spincyc/yoke/site/pages/index.md

<span id="connect-endpointskeep-control-at-the-edge" class="legacy-anchor" aria-hidden="true"></span>
<section class="product-hero">
<div class="hero-copy">
<p class="eyebrow">Yoke USB</p>
<h1>Connect USB devices<br>over Ethernet.</h1>
<p class="hero-lead">Plug a USB device into one Yoke box and your computer into another. Connect both boxes to your Ethernet switch. Pair the boxes once; they remember the connection.</p>
<div class="hero-actions"><a class="button" href="usb.md">USB hardware <span aria-hidden="true">→</span></a><a class="text-link" href="how-it-works.md">How it works <span aria-hidden="true">↗</span></a></div>
<p class="hero-note">Prototype: Radxa ZERO 3E. USB 2 first. <a href="docs/project-status.md">Development status</a></p>
</div>
<div class="hero-visual">
<figure id="network-title" class="product-figure"><picture><source media="(max-width: 760px)" srcset="../assets/diagrams/product-scene-mobile.svg">A USB device connects to a Yoke hardware box. Ethernet joins it through a switch to a second Yoke hardware box, which connects by USB to a separate computer.</picture><figcaption id="network-description">Two hardware boxes, with a USB cable at each end.</figcaption></figure>
</div>
</section>

<span id="a-small-command-surface" class="legacy-anchor" aria-hidden="true"></span>
<section class="product-section">
<div class="section-heading"><p class="eyebrow">USB / HDMI / IR</p><h2>Small boxes for the connections you need.</h2><p>USB is the first hardware prototype. HDMI and IR boxes are also part of Yoke. Each box works on its own, with management software as an optional addition.</p></div>
<div class="scenario-grid">
<article class="product-scenario"><span class="feature-number">01 / USB</span><h3>Use a USB device in another room.</h3><p>A box beside the device connects to a second box beside your computer. Both use Ethernet; your computer connects by USB.</p><a href="usb.md">USB hardware <span aria-hidden="true">→</span></a></article>
<article class="product-scenario"><span class="feature-number">02 / HDMI · Planned</span><h3>Connect a video source to a screen.</h3><p>An HDMI box at each end carries the connection over Ethernet. Choose which source feeds each screen.</p><a href="product.md#hdmi">HDMI hardware <span aria-hidden="true">→</span></a></article>
<article class="product-scenario"><span class="feature-number">03 / IR · Planned</span><h3>Control equipment in the cabinet.</h3><p>An Ethernet-connected IR box sends signals to the equipment beside it. A two-jack version is planned for use alongside an existing control system.</p><a href="product.md#ir">IR hardware <span aria-hidden="true">→</span></a></article>
</div>
</section>

<section class="product-section">
<div class="section-heading"><p class="eyebrow">Pairing</p><h2>The boxes remember their pairing.</h2><p>Use a command to pair or unpair boxes. Their saved pairing survives a restart or a lost network connection. If the other box goes offline, the pairing stays saved while it waits.</p></div>
<div class="feature-grid">
<div class="feature"><h3>No running manager required.</h3><p>Close the setup tool after pairing. The boxes keep the connection themselves.</p></div>
<div class="feature"><h3>Use your own tools.</h3><p>Use the command line, Thermite, or another manager. The commands and protocol are documented.</p></div>
<div class="feature"><h3>Check each box.</h3><p>See its saved pairing, connection status, and errors. A separate monitor can listen without changing the pairing.</p></div>
</div>
</section>

<span id="working-software-an-open-hardware-roadmap" class="legacy-anchor" aria-hidden="true"></span>
<span id="follow-the-evidence" class="legacy-anchor" aria-hidden="true"></span>
<section class="product-section status-snapshot">
<div><p class="eyebrow">Development</p><h2>Build the prototype or try the software.</h2><p>The USB design uses two Radxa ZERO 3E boards. Software simulations are available now; the complete USB bridge and hardware tests are still being developed.</p></div>
<div class="hero-actions"><a class="button" href="usb.md">USB prototype <span aria-hidden="true">→</span></a><a id="doc-search" class="text-link" href="docs/index.md#search">Documentation <span aria-hidden="true">↗</span></a></div>
</section>
