spincyc/yoke/hardware/usb-housing/r3/lid-detail.png

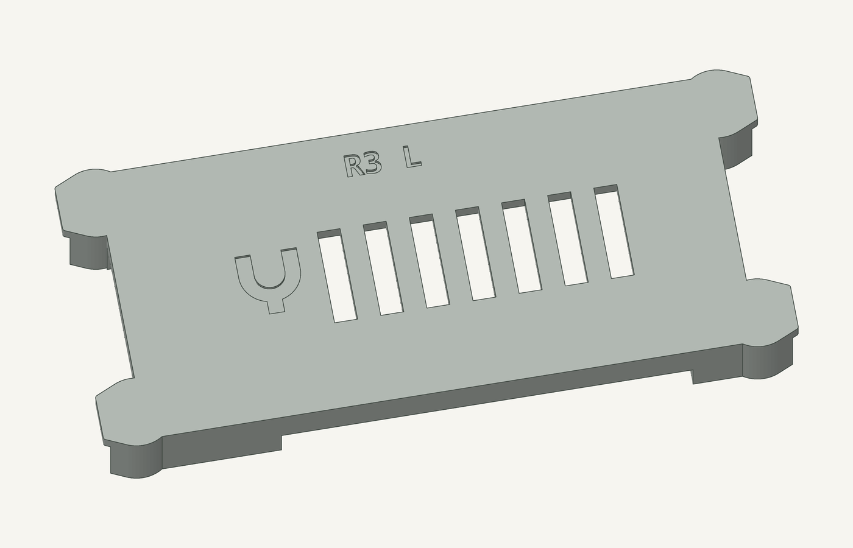
hardware/usb-housing/r3/lid-detail.png
