spincyc/yoke/hardware/usb-housing/r7/exploded.png

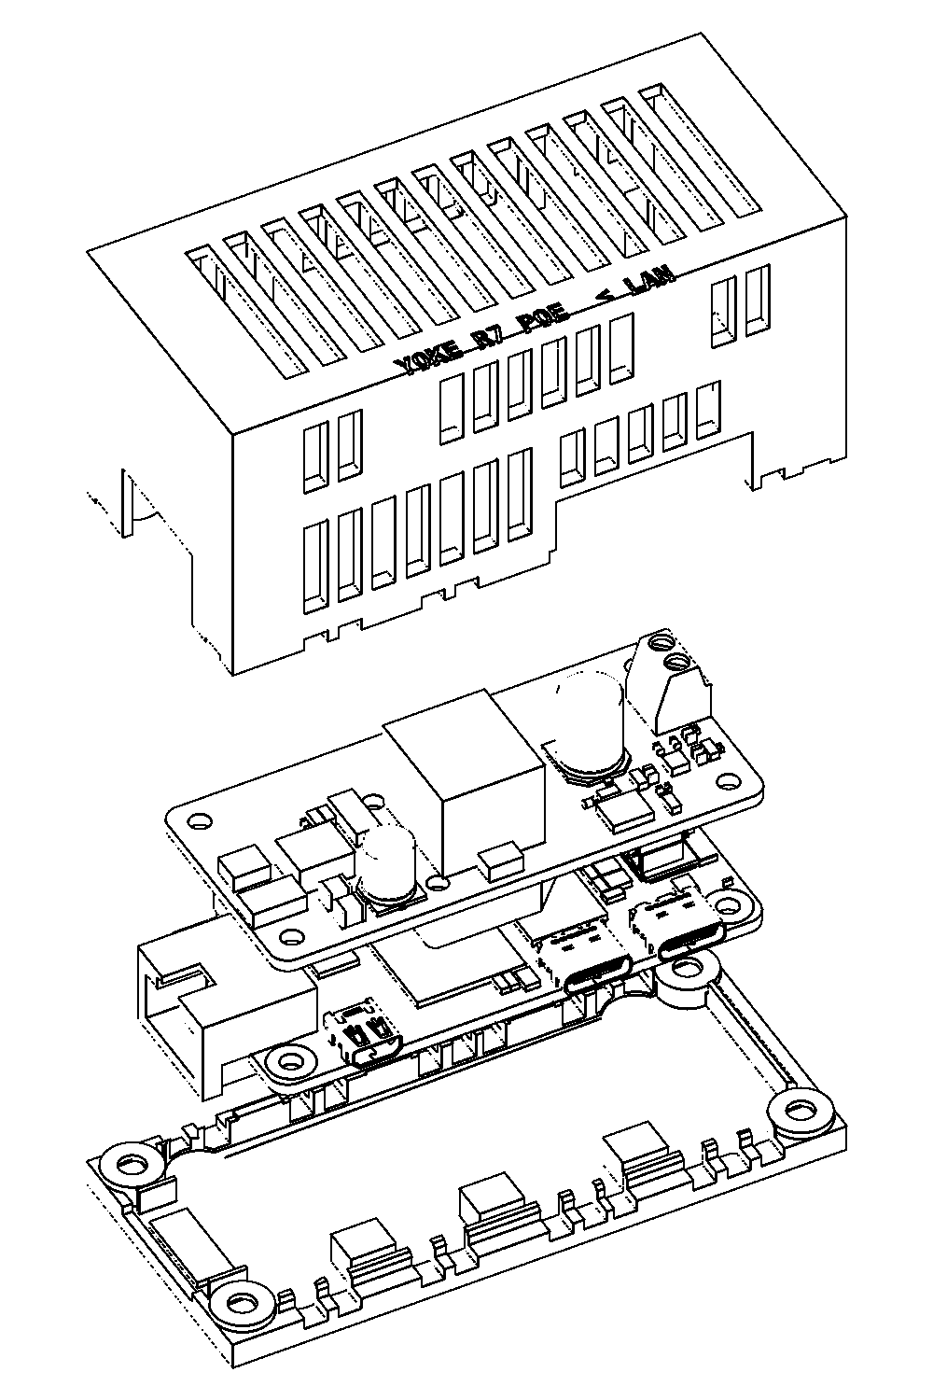
hardware/usb-housing/r7/exploded.png
