spincyc/yoke/hardware/usb-housing/r7/section.png

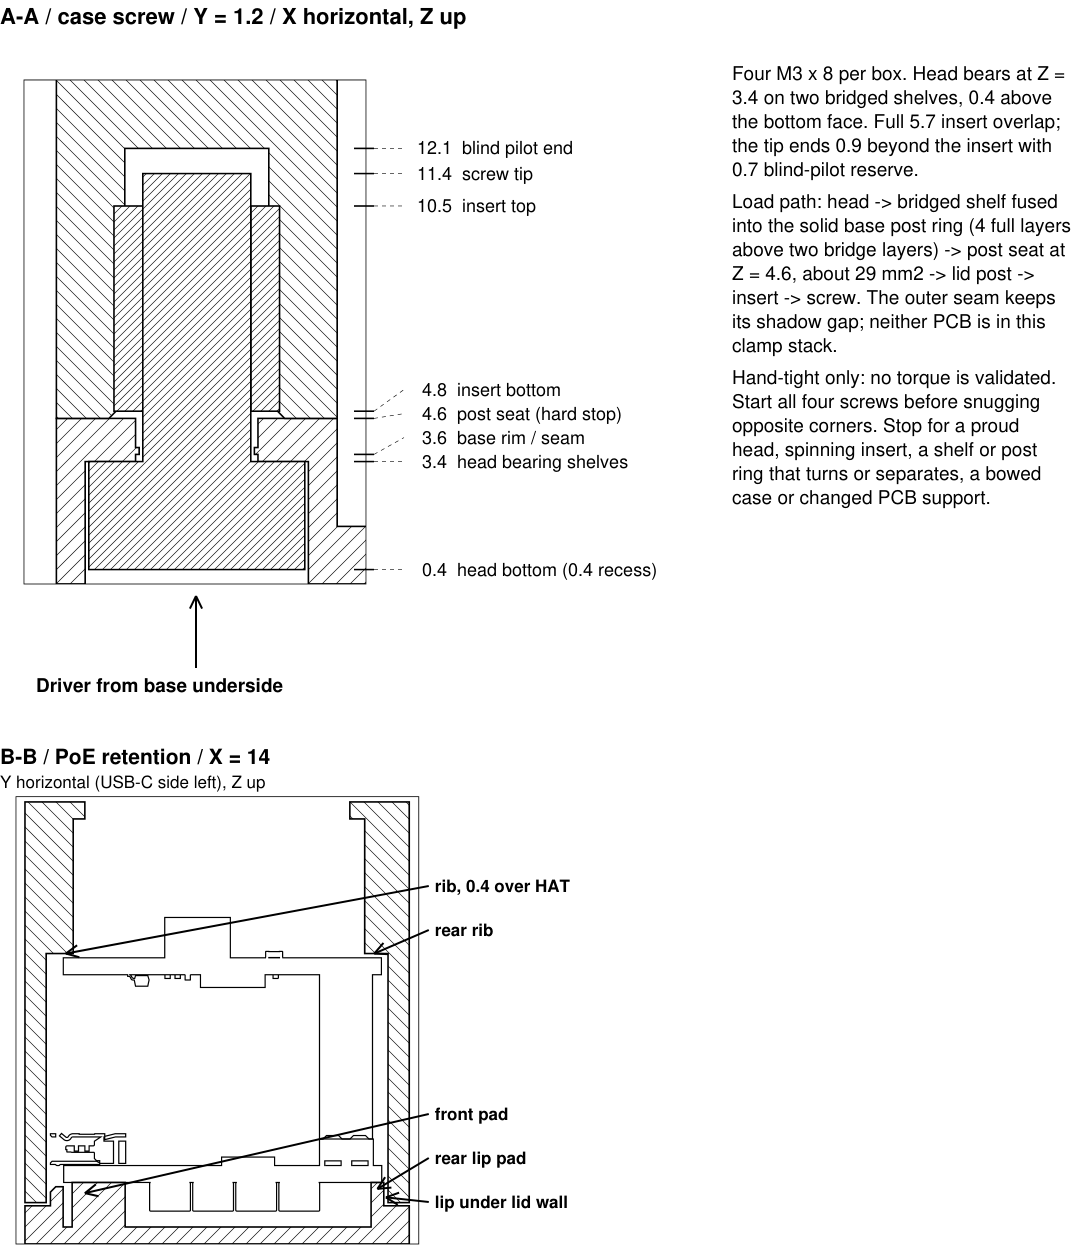
hardware/usb-housing/r7/section.png
