spincyc/yoke/hardware/usb-housing/lid-printed.stl

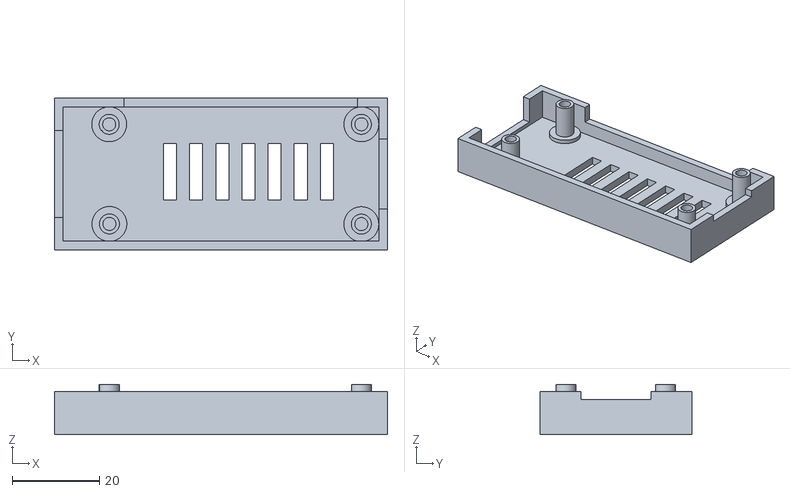
[picture p15: CAD file, 2026-11-02]
hardware/usb-housing/lid-printed.stl
76.4 x 34.8 x 11.5
