spincyc/yoke/hardware/usb-housing/r3/lid-printed.stl

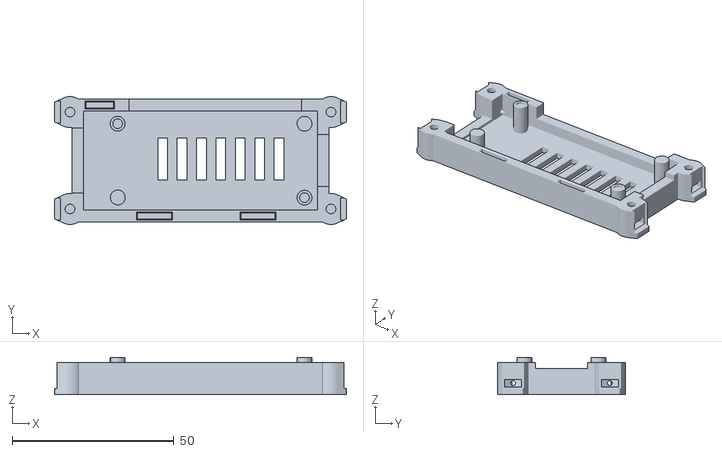
[picture p16: CAD file, 2026-11-03]
hardware/usb-housing/r3/lid-printed.stl
90.4 x 39.6 x 11.5
