spincyc/yoke/hardware/usb-housing/base.stl

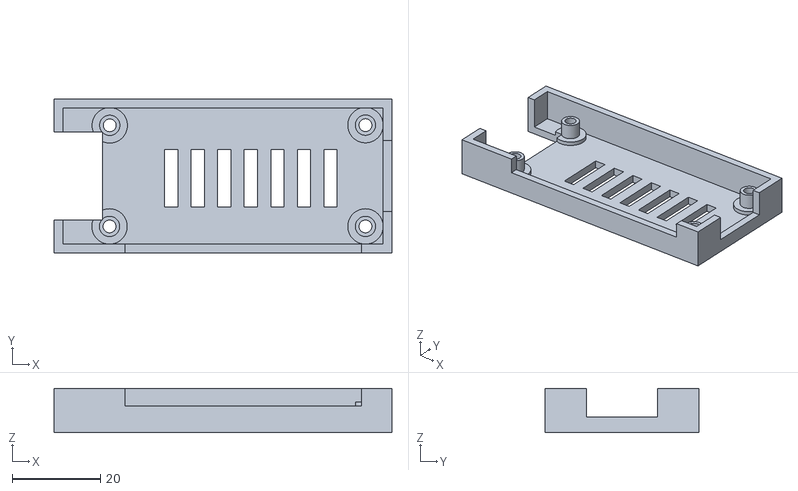
[picture p17: CAD file, 2026-11-02]
hardware/usb-housing/base.stl
76.4 x 34.8 x 10.0
