spincyc/yoke/hardware/usb-housing/r3/coupon-lid-printed.stl

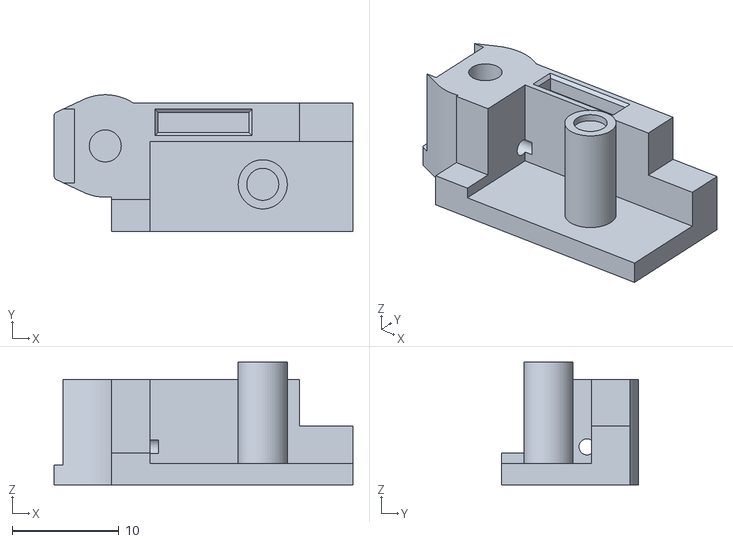
[picture p18: CAD file, 2026-11-03]
hardware/usb-housing/r3/coupon-lid-printed.stl
28.0 x 12.8 x 11.5
