spincyc/yoke/hardware/usb-housing/r2/yoke-usb-housing-r2.stl

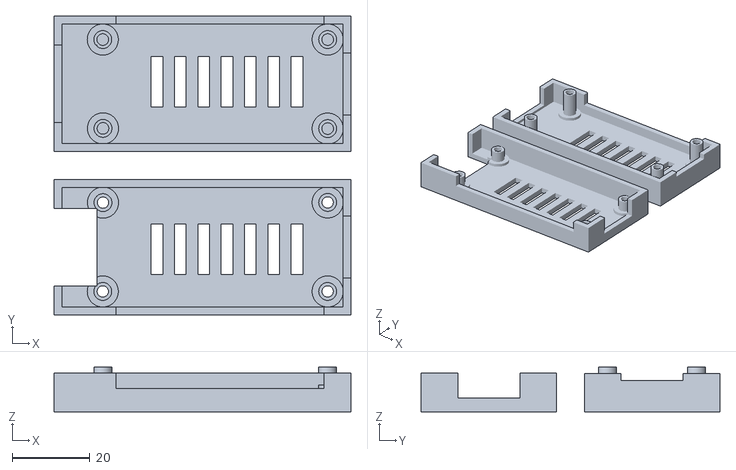
[picture p19: CAD file, 2026-11-02]
hardware/usb-housing/r2/yoke-usb-housing-r2.stl
76.4 x 76.8 x 11.5
