spincyc/yoke/hardware/usb-housing/r3/base-printed.stl

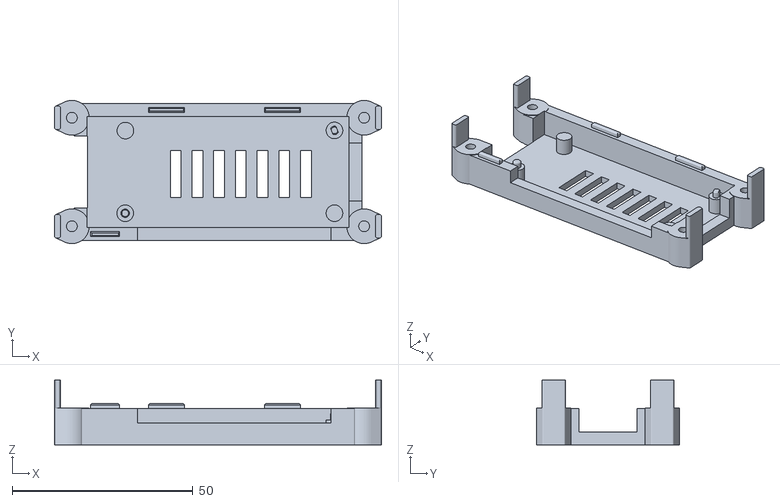
[picture p20: CAD file, 2026-11-03]
hardware/usb-housing/r3/base-printed.stl
90.4 x 39.6 x 17.9
