spincyc/yoke/hardware/usb-housing/r3/yoke-usb-housing-r3-coupon.stl

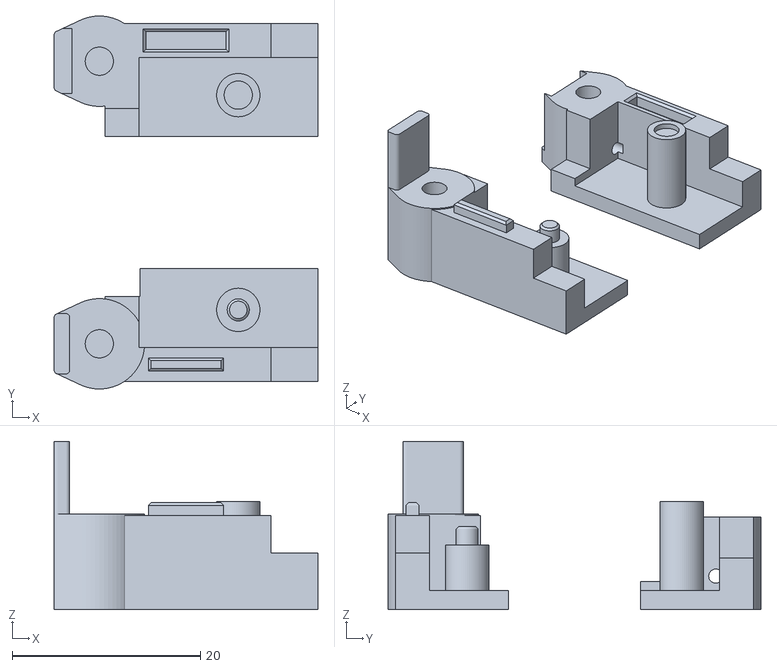
[picture p21: CAD file, 2026-11-03]
hardware/usb-housing/r3/yoke-usb-housing-r3-coupon.stl
28.0 x 39.6 x 17.9
