spincyc/yoke/hardware/usb-housing/r3/coupon-base.stl

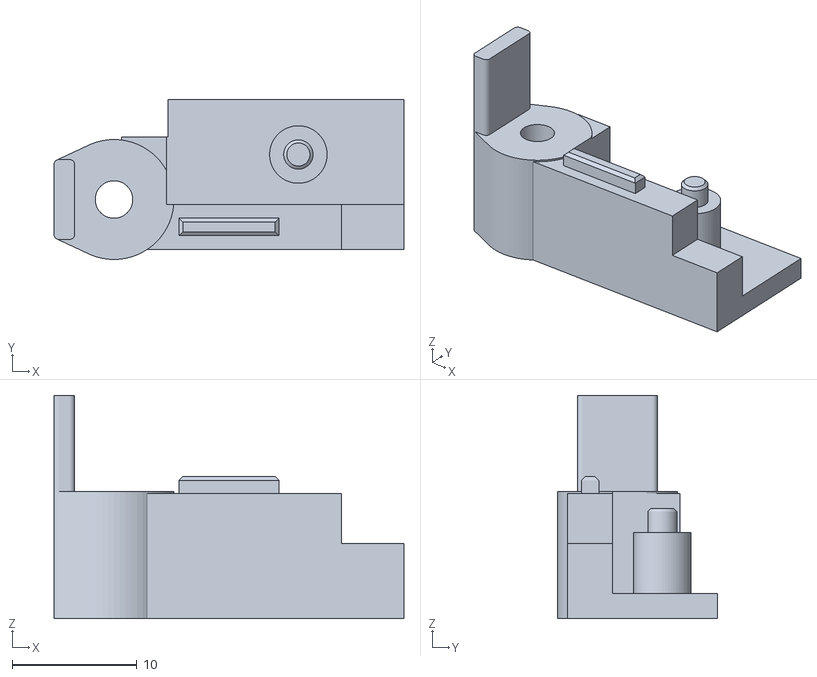
[picture p22: CAD file, 2026-11-03]
hardware/usb-housing/r3/coupon-base.stl
28.0 x 12.8 x 17.9
