spincyc/yoke/hardware/usb-housing/r3/yoke-usb-housing-r3.stl

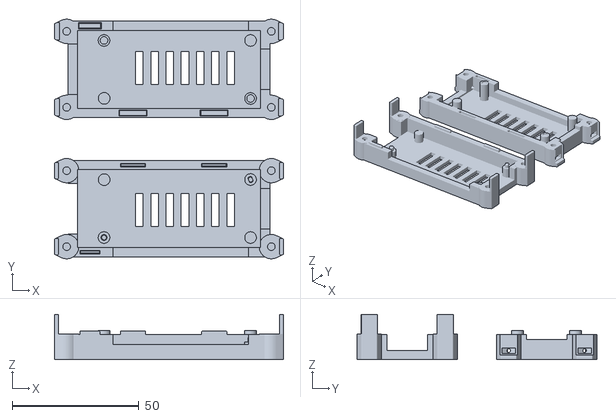
[picture p23: CAD file, 2026-11-03]
hardware/usb-housing/r3/yoke-usb-housing-r3.stl
90.4 x 94.6 x 17.9
