spincyc/yoke/(list of files, cad)

Other CAD files:
hardware/usb-housing/yoke-usb-housing-r1.stl
hardware/usb-housing/lid.stl
hardware/usb-housing/r3/coupon-lid.stl
hardware/usb-housing/r3/lid.stl
hardware/usb-housing/r3/base.stl
hardware/usb-housing/r2/base.stl
hardware/usb-housing/r2/lid-printed.stl
hardware/usb-housing/r2/lid.stl
hardware/usb-housing/r2/housing.scad
hardware/usb-housing/r5/housing.scad
hardware/usb-housing/r6/housing.scad
