spincyc/yoke/site/pages/guides/index.md

# Guides

For the hardware, start with the [USB boxes and wiring](../usb.md).
For software development without boards, [run the tests](../start.md).

## Connect and operate

| Task | Guide |
|---|---|
| USB hardware and firmware work | [Selected design](../../../doc/design/USB-ENDPOINT.md) |
| Change a pairing | [Pair configured endpoints](pairing.md) |
| Inspect devices or add a manager | [Monitor and integrate](monitoring.md) |
| Test a software adapter | [Backend reference](../reference/backends.md) |
| Provision identities, keys, and services | [Deployment](../../../doc/design/DEPLOYMENT.md) |
| Exercise sender, receiver, and observer | [Media testing](../../../doc/design/MEDIA-TESTING.md) |

## Maintain an endpoint

| Task | Guide |
|---|---|
| Update software running inside a box | [Linux updates](../../../doc/design/UPDATES.md) |
| Provision or update the ESP32 reference firmware | [ESP32 updater](../../../doc/design/ESP32-UPDATES.md) |
| Check the case redesign | [Housing status](../../../doc/design/USB-HOUSING.md) |

Update and enclosure guides document development references; see
[project status](../docs/project-status.md) before planning a hardware
deployment. Engineering validation belongs in the
[verification guide](../verification.md).
