spincyc/yoke/firmware/esp32/verify.py

#!/usr/bin/env python3
"""Explicit software-only firmware verification; installs build tools in .scratch.

Requires git, bash, cmake, ninja, cc, OpenSSL, and Python 3.12+. Default mode
downloads pinned developer dependencies. --offline reuses installed tools and
performs no installation. Neither mode contacts or flashes a device.
"""

import argparse
import hashlib
import json
import os
import shutil
import subprocess
import sys
import tomllib
import xml.etree.ElementTree as ET
from pathlib import Path

ROOT = Path(__file__).resolve().parents[2]
SCRATCH = ROOT / ".scratch/esp32-ota"
IDF = SCRATCH / "esp-idf"
IDF_TAG = "v5.5.6"
IDF_COMMIT = "880a203ae603d08a94d06aa01e0d6761958e5e9e"
MINIMUM_TESTS = 132
# ESP32-S3 internal SRAM instruction bus; flash-mapped code is 0x42xxxxxx.
IRAM = range(0x40370000, 0x403E0000)
ISR_SYMBOLS = ("ir_tx_fill", "ir_tx_extend", "__wrap_esp_panic_handler")


def run(command: list[str], env: dict[str, str], *, capture: bool = False) -> str:
    result = subprocess.run(
        command, cwd=ROOT, env=env, check=True, text=True, capture_output=capture
    )
    return result.stdout if capture else ""


def environment(jobs: int) -> dict[str, str]:
    env = dict(os.environ)
    for key in ("PYTHONHOME", "VIRTUAL_ENV", "IDF_PYTHON_ENV_PATH", "PYTEST_ADDOPTS"):
        env.pop(key, None)
    # export.sh must detect the same Python that prepared the SDK environment.
    env["PATH"] = os.pathsep.join(
        [str(Path(sys.executable).parent), str(Path.home() / ".local/bin"), env["PATH"]]
    )
    values = {
        "IDF_PATH": IDF,
        "IDF_TOOLS_PATH": SCRATCH / "tools",
        "TMPDIR": SCRATCH / "tmp",
        "XDG_CACHE_HOME": SCRATCH / "cache",
        "PIP_CACHE_DIR": SCRATCH / "cache/pip",
        "PYTHONPYCACHEPREFIX": SCRATCH / "cache/pycache",
        "CCACHE_DIR": SCRATCH / "cache/ccache",
    }
    for key, value in values.items():
        env[key] = str(value)
        value.mkdir(parents=True, exist_ok=True)
    env["IDF_PY_BUILD_JOBS"] = str(jobs)
    env["PIP_DISABLE_PIP_VERSION_CHECK"] = "1"
    return env


def check_sdk(env: dict[str, str]) -> None:
    actual = run(["git", "-C", str(IDF), "rev-parse", "HEAD"], env, capture=True)
    if actual.strip() != IDF_COMMIT:
        raise RuntimeError(f"SDK must be {IDF_TAG} commit {IDF_COMMIT}")
    changes = run(
        ["git", "-C", str(IDF), "status", "--porcelain", "--untracked-files=no"],
        env,
        capture=True,
    )
    if changes.strip():
        raise RuntimeError("SDK or its submodules have tracked modifications")
    modules = run(
        ["git", "-C", str(IDF), "submodule", "status", "--recursive"], env, capture=True
    )
    if not modules or any(line[:1] != " " for line in modules.splitlines()):
        raise RuntimeError("SDK submodules must match the pinned superproject")
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
