spincyc/yoke/(commit log)

2026-08-08 Design and seam: architecture, YWP/1 protocol, ADRs, core types, wire format
    Yoke pairs HDMI/USB producers to consumers over switched Ethernet with no
    central controller: consumer-owned pairing state, totally ordered multicast
    intents, anti-entropy re-send, HMAC-PSK auth, passive snooper. Media plane
    delegated to endpoint hardware (ADR 0002/0004); sans-I/O core for offline
    testability (ADR 0006).
2026-08-08 Hardware research: JAP primary, IPMX premium, usbip/Icron for USB
    Nine-lane web research synthesized: bit-transparent HDMI over 1GbE is
    impossible (endpoint silicon compresses; HDCP stays in licensed hardware,
    confirming ADR 0004); Just Add Power's per-device API + IGMP decoder-side
    switching is exactly yoke's controllerless model; IPMX/NMOS IS-05 is the
    standards-based upgrade path; USB 3.x over switched Ethernet does not
    exist anywhere. UniFi network prerequisites and bench-verification queue
    recorded.
2026-08-08 JAP decoder driver, agent config, atomic state persistence
    The Just Add Power driver encodes the researched control model (per-device
    channel command; bench-unverified assumptions isolated and executable in
    scripted-transcript tests). TOML config with fail-fast validation; state
    saved via write-fsync-rename so persist-before-ack survives crashes.
    [jap.py]
2026-08-08 Media-plane drivers: shellcmd seam, sim, usbip, igmp reference
    All offline-tested (57 tests): scripted FakeRunner transcripts encode the
    exact usbip output formats coded against; IGMP driver joins membership
    only and never reads payload; SimDriver is scriptable for every failure
    mode the simulation needs.
    [igmp.py, shellcmd.py, sim.py, usbip.py]
2026-08-08 Frames hardening from review; deployment guide and examples
    The 101-test frames suite exposed three gaps, now fixed with regressions:
    v accepted true/1.0 via Python equality, encode allowed bool seq, and the
    integers-only rule was unenforced (now: encoders reject floats outside
    ts, decoders stay tolerant — PROTOCOL.md updated to say exactly that).
2026-08-08 Multicast socket helper with loopback smoke test; contributor guidance
2026-08-08 Sans-I/O node state machine with full offline test suite
    Consumer intent pipeline (persist-before-ack, idempotent re-ack, version
    supersession, rejections), driver-status transitions with capped backoff,
    peer tracking with loss/return semantics, anti-entropy intent cache with
    verbatim re-send and suppression, replay defense, rate-limited rx-drop
    telemetry, deterministic seeded jitter. Spec resolutions recorded in the
    module docstring.
2026-08-08 Asyncio agent runner; integration fixes from lane review
    Runner executes node effects in order with driver I/O isolated on a
    locked thread, survives persist failures and encode bugs, and sends bye
    on cancellation. Integration gaps closed: Node.node_id is public, and
    usbip producers now bind at start / unbind at stop with failures
    surfacing as driver-error events (regression-tested).
2026-08-08 ADR 0009: re-issued anti-entropy; rejected intents evicted mesh-wide
    The simulation suite exposed a livelock: verbatim intent re-sends were
    stale-dropped once the author's seq advanced via traffic to any other
    consumer, so an offline consumer could never converge and bystanders
    re-offered forever. Anti-entropy now re-issues the cached intent body
    under the relayer's own origin/seq (authorship preserved in the body
    version); nodes observe rejection acks and evict/pin the exact rejected
    version so doomed intents stop circulating. Convergence property tests
    unpinned (shared origins + invalid intents, seeds 0-99 clean); livelock
    and rejection-eviction regressions added at both node and mesh leve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
2026-08-08 Adversarial review fixes: DoS hardening, deferred-kind, seq unit, docs
    22 confirmed findings from a multi-agent review, addressed:
    Critical: a non-ASCII sig crashed hmac.compare_digest (TypeError) before
    verification, so one crafted datagram killed every agent and the snooper
    in open OR keyed mode. sig now must be 64-hex-or-empty before compare
    (ADR 0010).
    Major: deferred kind-mismatch no longer attaches wrong-kind media (and
    role-flips detach + go pending); a spoofed far-future seq can no longer
    permanently mute an origin (seq unified on Unix nanoseconds via exact
    integer math, bounded 1h ahead — ADR 0007/0010); per-origin maps are
    pruned and FIFO-capped against id-cycling exhaustion; r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
2026-08-08 Field-scenario coverage: shared producer, re-pair, producer reboot, forged frame
    Five simnet scenarios for realistic field conditions: two HDMI consumers
    sharing one producer (independent pairings, both active), re-patching a
    consumer between producers, producer reboot mid-stream with recovery, a
    forged wrong-PSK frame ignored, and unpair-then-repair. Two behavioral
    properties documented inline: re-pair relies on driver-level group switch
    (no explicit detach), and unpair surfaces as pairing-applied(null) rather
    than media-down.
2026-08-09 Prototype-to-product hardware research and phased build plan
    Nine-lane research synthesized into a buildable plan. Core findings:
    uncompressed video over IP (RFC4175/ST2110) is bit-transparent, zero-
    license, and fits 1080p60 on 10G / 4K60 on 25G — the user's fabric makes
    'interpret and reproduce transparently' literally uncompressed pixels
    over Ethernet. VC-2/Dirac is the royalty-free compressor for the one cell
    that doesn't fit. Latency: SBC ~35-55ms, FPGA line-based ~5-16ms. Biggest
    shortcut: Sunshine + moonlight-embedded -platform rk is a finished
    network->real-HDMI consumer on RK3588. HDCP is the hard fork for protected
    content (Apple TV/Sony): licensed repeater required (no per-unit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
2026-08-09 Compression sweet-spot analysis: the latency cliff and the visually-lossless band
    Quantifies the sliding-compression trade-space: latency vs ratio is flat
    (sub-ms) through the line-based regime (~1:1-6:1) then cliffs to 16-80ms
    at frame-based coding. Sweet spot = line-based, visually-lossless, ~2.5-
    4:1, sub-1ms, turning 4K60's ~10Gbps into ~2.5-4Gbps. The saved headroom
    funds ST2022-7/FEC, so a little compression is the reliability play that
    makes transparent survive a shared switched fabric — plus a closed-loop
    controller that slides within the visually-lossless band under QoS
    pressure. Design center for both the unprotected mesh and the licensed
    product; needs a line-based codec (SVT-JP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
2026-08-09 Media pipeline seams: sans-I/O stage contracts, types, design, hardware pick
    The media plane mirrors the control plane: sans-I/O Stage transforms
    emitting observable StageEvent taps, a Pipeline that threads units with
    fan-out, and a non-interference contract (forward output independent of
    who reads the taps) that makes the stream snoop-verifiable. MediaUnit
    carries a source digest for end-to-end integrity. MEDIA.md is normative;
    HARDWARE-PLATFORM.md gives the staged platform pick (pure software now ->
    x86+E810 for the JPEG-XS sweet spot -> FPGA -> licensed product).
2026-08-09 Media pipeline stages, snooper, metrics, stream driver, network sim
    Six sans-I/O stages (source, codec, ratecontrol, packetize, fec, jitter,
    sink), a passive white-box+black-box media snooper and metrics collector,
    the stream media driver (control-plane -> pipeline-process bridge via an
    injected supervisor seam), and a seeded media network simulator. Each
    stage independently tested; the snooper reconstructs stream health from
    taps or the wire without touching the stream (oracle + non-interference
    tested). All stdlib-only, mypy --strict, offline.
2026-08-09 Media wire codec and pipeline assembly
    wire.py bridges the sans-I/O pipeline to real sockets: a PACKET unit
    becomes [RTP header][yoke trailer][fragment] and back losslessly, keeping
    the leading RTP header standard so the black-box snooper parses it off the
    wire. assembly.py composes the canonical sender/receiver pipelines from
    one MediaConfig so the runner, offline tests, and CLI build identical
    stacks. Validated end-to-end in-process (source->wire->sink, bit-exact).
2026-08-09 Asyncio media runner over real UDP; loopback-validated end to end
    SenderRunner produces frames at cadence and sends wire packets, consuming
    feedback to drive rate control; ReceiverRunner ingests packets, ticks the
    jitter buffer, emits feedback, and feeds a passive snooper. Smoke: 60
    frames over 127.0.0.1, bit-exact, zero loss, feedback flowing.
2026-08-09 Media end-to-end tests (offline sim + real-socket loopback); metrics/wire fixes
    Offline integration over the seeded sim (13 tests): clean, loss with/
    without FEC (XOR recovers 51 vs 40 frames under 7% loss; dup survives a
    full path loss), reorder+jitter resequencing, rate adaptation (2.5->6.0,
    frame_bytes 212->88), corruption caught. Real-socket loopback (9 tests
    over 127.0.0.1): bit-exact delivery, snooper non-interference verified,
    malformed datagrams counted, feedback loop, dup-FEC dedup, multi-fragment
    reassembly, measured loopback latency mean ~8.3ms/max ~16.5ms.
    Fixes from integration: MetricsCollector wire boundary now measures at
    packetize(OUT)/depacketize(IN) — the stages that em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
2026-08-09 yoke media debug CLI, two-host make targets, correct effective-ratio metric
    CLI (19 tests): simulate/probe/trace/snoop/run with --dry-run — all logic
    in pure string-returning helpers, sockets only in main(). 'run --role
    sender|receiver' is the single-command two-host entry; make media-send
    PEER=/media-recv wrap it. Registered yoke-media console script.
    Effective ratio now uses the codec's own applied ratio (raw 1.00:1,
    jpegxs 2.50:1) instead of dividing mismatched modeled/actual byte bases
    that read a nonsense 2923:1. README documents the media plane + tools.
2026-08-09 Fix stream sender socket to bind ephemeral, not the destination port
    The live 'yoke media run --role sender' bound the receiver's port on the
    same host, stealing its inbound datagrams (harmless across two hosts via
    multicast, but broke same-host loopback demonstration). Senders now bind
    an ephemeral local port and send to the destination; multicast senders set
    TTL/LOOP. Validated: two CLI processes over 127.0.0.1 deliver frames
    bit-exact with the snooper reconstructing every stage.
2026-08-09 Deep FPGA cost search: floor is ~$130-195/endpoint (Gowin), not $500
    Two research lanes: the Xilinx/Kintex route really does sit ~$500/endpoint
    (cheapest K7+SFP+ board has no HDMI -> add an FMC HDMI card), but the Gowin
    GW5A route (Sipeed Tang Mega 138K Pro ~$175-195) undercuts it 2.5-4x with
    native DVI-Rx capture + 2x SFP+ 12.5G, carrying uncompressed 1080p60. Both
    agree: HDMI-in is the gatekeeper (kills ECP5/Colorlight), no free FPGA
    compression core exists, Artix/ECP5 can't clock 10G, HDCP is a separate
    wall, two endpoints double the cost. Gowin TMDS-Rx margin + toolchain
    maturity are the risks to pilot. FPGA-COST.md has the head-to-head.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
2026-08-09 Add handoff doc for the next agent
    Captures project state (control plane + software media pipeline, all
    committed, make verify green), the evolved requirements — especially the
    late-stated 4K120 absolute-floor and pin-to-pin (not GStreamer) product
    constraints — and the honest hardware conclusion: 4K120 needs HDMI 2.1 FRL
    ingest + 25G+ GTY FPGA + licensed light compression (the $k/licensed
    tier), while the cheap $130-195 Gowin path only prototypes the 1080p60
    architecture. Records open decisions and the top next task (a focused
    4K120 hardware search, not yet done).
2026-08-09 Establish the 4K120 hardware floor (four-lane deep search)
    Transparent 4K120 over switched IP is bleeding-edge — nothing commercial
    ships it (all AVoIP caps at 4K60/HDMI2.0/10G). The whole problem reduces
    to HDMI 2.1 FRL ingest, which is Lontium-or-Bitec: merchant 4K120 FRL RX
    silicon is essentially Lontium alone (~$15-25/chip). Letting the Lontium
    bridge do FRL+DSC decode avoids the paid AMD HDMI2.1/DSC/HDCP IP for the
    license-free DIY path. Format fork sets the tier: 4:2:2-10 (~20G) fits 25G
    uncompressed license-free (strict superset of cinematic HDR sources), 4:4:4
    (~30G) needs 100G or self-DSC. Floors: cinematic prototype ~$1,650-2,000/
    endpoint license-free (Lontium FRL4 + KU5P FMC +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
2026-08-09 Persist the closet-to-desk KVM build spec for a cold agent
    Captures the first committed concrete build: transparent full-bandwidth
    (4K120) low-latency PC-gaming KVM, A/V closet -> remote monitor+USB.
    Diagnosed why commercial extenders fail (USB wedges = relayed timing w/ no
    supervisor; video flicker/black = EDID/HPD + FRL link-training, not
    bandwidth) and the build principle that fixes both (terminate+regenerate +
    own session state + yoke as supervisor). Build order HDMI-handshake-first
    -> USB -> integrate; parts, milestones, and the two open decisions
    (transport, monitor spec). HANDOFF.md now points to it as the active work.
2026-08-09 Design the edge devices: full HDMI + USB paths over switched UniFi
    Transport decided by the user: the switched UniFi network; point-to-point
    fiber ruled out. New requirement folded in: the USB mesh must carry
    WinWing gear including their USB3 video displays.
    doc/design/EDGE-DEVICES.md is new: full-path designs, buyable BOMs, and
    milestone revisions, synthesized from a nine-lane live-web hardware
    search and hardened by a three-lens adversarial review (all confirmed
    findings folded in — EDID synthesis not passthrough, HPD hysteresis +
    local-training rule, GXC D-PHY 20G gate, DSC-as-EDID-knob, Windows-only
    T1 status, PC-side watchdog, Icron waiver, vhusb mesh seam, FEC probe
    gate, restored l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
2026-09-25 Consolidate research into a current, non-contradictory doc set
    Cold review (2026-09-24) of the earlier conclusion that yoke's goal (a
    decentralized, reconfigurable mesh of HDMI and USB bridges over switched
    IP) is not possible. Rejected: that conclusion conflated "no one sells
    it" with "cannot be built", assumed 25G uncompressed as the only 4K120
    route, and missed GPU-side DSC. On the user's 10GbE baseline, 4K120 fits
    as the GPU's own DSC stream over DisplayPort (~8 Gb/s, sub-ms, gated on
    Lontium NDA silicon); only bit-exact 4K 4:4:4 at >=60 Hz (physics) and
    HDCP in a DIY endpoint (law) are impossible.
    - New doc/research/FEASIBILITY.md: verdict, arithmetic, ranked 4K120
    routes, and a tabl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
    [stream.py]
2026-09-25 HDCP pass-through: correct the feasibility verdict, propose ADR 0011
    The earlier docs held that protected content needs a licensed HDCP
    repeater and that the locality check makes a relay impossible. Both are
    wrong for a LAN: a bridge that forwards ciphertext untouched and tunnels
    the DDC handshake verbatim is invisible to source and sink (how HDMI
    extenders work), and the locality check allows 20 ms round trip on HDMI
    against ~0.3 ms on a switched LAN. The real limit is bandwidth:
    ciphertext cannot be compressed, so 10G carries protected content up to
    ~4K60 4:2:0 or 4K24; 4K60 4:2:2 12-bit needs 25G, 4K120 40G+.
    - FEASIBILITY.md: new HDCP section (rates, raw-capture/timing/handshake
    requi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
2026-11-02 Prepare standalone Yoke endpoints and public documentation
    Make pairing commits durable, bound and serialize backend effects, and
    reconcile USB/IP imports without disturbing unrelated sessions. Add
    software fault campaigns, multicast media observation, bounded transport
    models, and measured performance improvements.
    Provide operator-controlled Linux/ESP32 Ethernet update references,
    reviewed Radxa housing files and shared restrained brand assets. Add an
    accessible local docs site gated by Python and firmware checks.
    Validation: make verify (1,445 tests); ESP32 verifier (39 tests, no skips,
    plus target build); independent control, media, driver, update, and CAD
    reviews. Physical endpoint be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
    [base.stl, housing.scad, lid-printed.stl, lid.stl, partitions.csv, yoke-usb-housing-r1.stl, yoke-usb-housing-r2.stl]
2026-11-02 Add optional telemetry export and endpoint terminal monitor
    Passively observe accepted YWP/1 frames, sample collector-host resources,
    and cache Prometheus and versioned JSON snapshots without affecting agents
    or routing. Add a reusable Python curses monitor with offline demo, remote
    viewing, bounded histories, and explicit source freshness and host scope.
    Document research, cadence, counter semantics, network exposure and measured
    software costs. Keep the runtime standard-library-only and monitoring
    independent of Thermite or any other manager.
    Validation: 1698 tests passed, 10 optional firmware SDK tests skipped locally;
    41-page strict docs build; independent cold reviews and real PTY che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
2026-11-03 Revise USB housing with locating joints and recessed metal fasteners
    The earlier flat seam did not register the halves and its screw heads sat
    outside the base. R3 adds three locating tongues, board locating pegs,
    recessed head wells, and side-loaded metal nuts captured by integral keepers
    when the case is closed. End lugs carry preload independently of the PCB.
    Use M2.5 x 16 mm screws, replacing the earlier 20 mm stack. Document the
    larger 90.4 x 39.6 x 20 mm envelope, controlled bore cleanup, measured stack
    acceptance, nut service sequence, fit coupon and bare-board limits. Include
    native CAD, reproducible meshes/plates, exact sections and assembly PDF.
    Validation: nominal geometry and 3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
    [base-printed.stl, base.stl, coupon-base-printed.stl, coupon-base.stl, coupon-lid-printed.stl, coupon-lid.stl, housing.scad, lid-printed.stl]
2026-11-03 Record R3 housing first-article print dispatch
    Record the exact reviewed and approved R3 main-plate job and its single filename-verified printer start. Link the append-only Lacuna ledger and refresh documentation status; physical fit, capture, cleanup, retention and thermal qualification remain NOT RUN.
2026-11-03 Rebuild Yoke around the product and verify Pages in a pinned browser
    Replace the design-review homepage with a restrained product identity, concrete responsive connection diagrams, a pairing demonstration and curated documentation journeys. Preserve existing URLs and anchors, and improve task-first search.
    Separate backend construction, deterministic media experiments, shared presentation helpers and documentation tooling along their existing boundaries while preserving compatibility aliases and behavior.
    Replace environment-dependent Chromium discovery and Node automation with pinned Python Playwright and mandatory browser gates on Python 3.12 and 3.14 before Pages deployment. Validate th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
    [factory.py]
2026-11-03 Correct USB product docs to the agreed two-box hardware design
    Document two Radxa ZERO 3E hardware boxes with physical USB connections to the peripheral and the separate user computer, with USB 2 first. The Linux USB/IP adapter is an unfinished implementation component, not a substitute product topology. Make that distinction explicit in current design docs and older research.
    Rewrite product copy, wiring diagrams, pairing examples and navigation in plain language. Record the owner-reported housing failure and retire R3 recommendations while the rectangular slotted M3 heat-set case is redesigned.
    Validation: make verify (1736 passed, 10 optional SDK skips), 56-page build, 336 browser cases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
2026-11-03 Redesign USB case with a sliding lid and internal M3 fasteners
    Keep the complete enclosure rectangular and recess both screw heads. Use the Lacuna M3 screw and RX heat-set insert types, with native joint coupons before a full-case trial. Add reproducible board-reference generation, nominal geometry checks, assembly drawings and an independent scoped review. Stock fit and all physical tests remain unverified; no R4 print release is issued. Mark earlier case instructions as historical.
    [housing.scad]
2026-11-03 Print reviewed R4 joint samples before a complete USB case
    Add a bounded coupon-trial export and a separate four-page test guide. Provide actual clamp lands and a stiffer rear fixture with a positive lower-part hold-down. The exact five-piece job passed independent assembly and toolpath review, then started once with the expected filename. Preserve the dispatch receipt; actual fit and full-case qualification remain unverified.
    [housing.scad]
2026-11-03 Record the printer material report for the coupon job
2026-11-03 Replace failed housing joints with a simple ventilated two-part case
    [housing.scad]
2026-11-03 Record PoE enclosure gap and current project handoff
2026-11-03 Record PoE housing reference conflict and retire bare-board guidance
2026-11-03 Identify owner PoE kit and distinguish fanless listing from CAD
2026-11-03 Build and dispatch vented R6 PoE housing first article
    [housing.scad]
2026-11-04 Harden control plane: clock-robust admission, USB/IP admission, logging
    Fix the cold-review findings of 2026-11-04 against YWP/1 and the USB/IP
    driver, each with a deterministic regression or simnet scenario:
    - Re-read wall time per frame and poll (node, runner, snoop, telemetry);
    an agent started before NTP now admits peers once the clock steps.
    - Bound the restart sequence floor to 60 s past the durable bound and add
    `yoke agent --rebase-sequence` instead of hand-editing state.
    - Authenticate transmitted bytes with the top-level sig member excised,
    still accepting the legacy canonical form; publish 27 auth vectors.
    - Stop a vanished owned import beside a pre-existing record-less vhc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
    [factory.py]
2026-11-04 Present remote USB devices through the computer-side gadget port
    The computer-side box previously imported the remote device into its own
    kernel with usbip attach, so the user's computer saw nothing. Add the
    missing data path, verified only in pure-software simulation:
    - yoke.usb: a userspace USB/IP 1.1.1 client that imports directly from
    the device-side stock usbipd (no vhci import, no local driver binding)
    and a Raw Gadget presentation backend driven through fcntl.ioctl,
    isolated behind GadgetBackend with ABI constants tested against the
    uapi header (bench-unverified).
    - Proxy: cached descriptors to meet USB 2.0 9.2.6.4 control deadlines,
    forwarded SET_CONFIGURATION/SET_INTERFAC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
    [build.py, factory.py, gadget.py]
2026-11-04 Install the gadget worker on the computer-side box and index ADRs 0021-0024
    The computer role of packaging/zero3e/install.sh now stages the
    unprivileged yoke-gadget worker unit, the raw_gadget module entry and a
    udev rule that gives only the yoke-gadget account access to
    /dev/raw-gadget; yoked stays unchanged. Add the computer-side
    usb-gadget consumer example, describe the driver in the backends
    reference, and list ADRs 0021-0024 in the decisions index.
2026-11-04 Wait for the retry failure before advancing the fake clock
    test_failed_prevalidation_keeps_old_health_stale_and_retries waited on the
    driver's attempt counter, which the executor thread increments when
    attach() starts. On a loaded machine the test advanced the fake clock
    before the failure reached the core, so the next 2 s backoff was
    scheduled past the final advance and the node never retried. Wait for
    the published driver-error event instead, which is emitted in the same
    core call that schedules the retry.
2026-11-04 Turn the ESP32 updater into an RMT IR endpoint with gated health
    IR moves to a standalone ESP32-S3/W5500 endpoint driven by the RMT
    peripheral (ADR 0025), replacing the Radxa pwm-ir-tx and Arduino Mega
    options. A pure-C yoke_ir core parses an honest Global Cache iTach
    subset on TCP 4998 (getdevices, getversion with Make=Yoke, sendir,
    completeir after physical completion, busyIR, stopir, smooth repeat,
    optional learning). The API is off by default, LAN-scoped and rate-
    and size-bounded; admin and OTA stay on mutual-TLS HTTPS.
    Updater hardening (ADR 0026): confirm a new image only after IP or an
    observed link-down plus listeners and an RMT self-test; retry Ethernet
    and restart with RTC-kept b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
    [partitions.csv]
2026-11-04 Fix gadget binding and cancellation; prove the data path on a real kernel
    An independent review found the simulation encoded two wrong kernel
    assumptions. Fixes, each with a test:
    - Raw Gadget binds with the UDC driver name (dwc3-gadget, dummy_udc)
    separate from the device name (fcc00000.usb); the worker infers it
    from sysfs. Previously RUN would fail with EBUSY on the RK3566.
    - Ioctls go through ctypes (one call, GIL released, no PEP 475 retry),
    so pthread_kill cancellation really unblocks EVENT_FETCH/EP_READ and
    teardown is confirmed; per-thread join deadlines.
    - EPIPE after a host CLEAR_FEATURE(HALT) is a cleared halt, not a fault.
    - USB/IP unlink tombstones tolerate the stock st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
    [gadget.py]
2026-11-04 Describe the gadget data path, IR endpoint and computer-side power
    Update the README, project status, architecture tree and engineering
    index for the computer-side USB bridge, the ESP32 RMT IR endpoint and
    the USB-powered computer-side box, and list ADRs 0025 and 0026.
2026-11-04 Replace R6 with compact R7 PoE and computer-side housings, and print them
    The owner judged the printed R6 PoE housing too large (89 x 45.5 x 46 mm).
    Its closed-end screw bosses and USB-side clip boss added about 13 mm of
    length and 9 mm of width and left the USB-C faces 9.5 mm inside the wall.
    R7 puts both boxes on one plate with one shared base design:
    - PoE device-side box 81.4 x 36.25 x 41.7 mm (34% less volume than R6);
    - bare computer-side box 81.4 x 36.25 x 18.5 mm for the USB-powered
    ZERO 3E without a HAT;
    - USB-C faces 2.15 mm from the wall; four recessed M3x8 screws into
    RX-M3x5.7 lid inserts; edge pads and lid ribs instead of clips; only
    the PoE lid depends on the 18 / 14.5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
    [housing.scad]
2026-11-04 Record the 2026-11-04 state: R7 printed, software verified, bench next
    Rewrite HANDOFF around the current state: computer-side gadget bridge
    verified in simulation and a real-kernel VM loopback, control-plane
    hardening, USB-powered computer-side box, ESP32 RMT IR endpoint and the
    R7 housings printed after a second independent review. Point the USB
    endpoint design, README and project status at R7 and the kernel test.
2026-11-04 Record the chipset research and review dispositions of 2026-11-04
    Add dated research pages so later sessions inherit the evidence rather
    than re-deriving it:
    - CHIPSETS.md: RK3566 DWC3 device controller and Raw Gadget naming,
    ZERO 3E OTG power path from the v1.2 schematic, RA023 PoE HAT limits,
    computer-side bus power budget, alternatives (Pi dwc2, MUSB, RK3568,
    RV1106, ESP32-P4, i.MX RT1170, Icron) and IR silicon (Rockchip
    pwm-ir-tx sleep path, ESP32 RMT, AVR), with the bench tests that decide.
    - REVIEW-2026-11-04.md: every consequential cold-review finding across
    the USB data path, control plane, ESP32 firmware, IR and housing, and
    whether it was fixed, accepted or left open.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
2026-11-04 Expect the IR endpoint design first in IR search results
    The browser check required project status within the top five results
    for "IR". The new IR endpoint design, ADR 0025 and the 2026-11-04
    research pages now rank above it, which is the more useful order, so CI
    failed. Keep the intent: IR must not match "pair"/"wire", the IR design
    and product overview rank in the top three, and project status stays on
    the first screen of results.
2026-11-05 Accept ADR 0027: tiered USB product line and a native C data path
    Record the owner's 2026-11-05 direction: tier 1 (ESP32-S3 + W5500, HID),
    tier 1.5 (ESP32-P4, high-speed compatible over 10/100), tier 2 (ZERO 3E
    with a native C gadget worker) and tier 3 (USB 3.0, research). One
    portable sans-I/O C core under native/ serves every tier; USB/IP stays
    the open data plane with compression as a negotiated extension; the
    Python worker becomes the reference oracle. The i.MX RT1170 evaluation
    kit was rejected for now on cost and size.
2026-11-05 Add native/ywp: YWP/1 pairing in portable C for microcontroller boxes
    A sans-I/O C11 implementation of YWP/1 (frames, transmitted-byte and
    legacy authentication, the node state machine, the runner's generation
    queue and a CRC-checked NVS state blob) for the ESP32 USB boxes (ADR 0027).
    It allocates one exactly sized block and builds as a plain library and as
    the ESP-IDF component "ywp".
    Equivalence with yoke.core is tested in tests/native_ywp: all 27 auth
    vectors; differential decode against Python (fuzz corpus, 0
    disagreements); lockstep against Node with evicting tables; every simnet
    scenario in four C/Python mixes with byte-identical bus traffic; and
    real-socket interop with yoke agent an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
2026-11-05 Add native/yusb: a portable C USB/IP core and the native gadget worker
    ADR 0027 tier 2 replaces the Python gadget worker in the data path, and
    the same core serves the ESP32 boxes (tiers 1 and 1.5).
    - native/yusb: a sans-I/O C11 library (plain library and ESP-IDF
    component "yusb"): USB/IP 1.1.1 codec, descriptor cache and rewrites,
    the computer-side presentation core (control relay, endpoint pumps,
    stall/halt/EPIPE/unlink/tombstones/reset), the device-side export core
    (a USB/IP server over a host-controller op table with a per-URB buffer
    pool), route fencing, and exact footprint functions for MCU budgeting.
    - yoke-gadget-worker: a drop-in for yoke.usb.worker (same CLI and ADR 0022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
    [buffers.c, buffers.h, ch9.c, client.c]
2026-11-05 Add the ESP32 USB box firmware for tiers 1 and 1.5
    firmware/esp32-usb is the microcontroller Yoke USB box (ADRs 0027, 0030):
    ESP32-S3 with a W5500 (tier 1, full speed) and ESP32-P4 with its EMAC
    (tier 1.5, high speed; build only). One role per boot:
    - computer: a TinyUSB application class driver mirrors the remote
    device's descriptors, defers class/vendor replies by NAK, delivers
    UDC-acknowledged requests as YUSB_EV_CONTROL_ACKED, and feeds the
    native/yusb presentation core;
    - device: the ESP-IDF USB Host Library feeds the native/yusb export core
    with TCP 3240 admission from YWP/1 ADMISSION effects (ADR 0024).
    YWP/1 pairing runs native/ywp in its own task (mbedTLS SHA-256, NVS,
    lwI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
    [partitions.csv]
2026-11-05 Describe the tiered USB line in HANDOFF, README and project status
    Record the 2026-11-05 state: tiers 1, 1.5 and 2 on one portable C core
    (native/yusb, native/ywp), the ESP32 USB box firmware and the native
    gadget worker, their software-only evidence, the new make targets, and
    the bench entry points for the hardware that arrived today. Index ADRs
    0027-0030 in the reading list.
2026-11-05 Guarantee write progress in the export core and settle ep0 edge cases
    A re-review found that a CMD_SUBMIT carrying OUT data could wait forever:
    reads parked on the device could hold every non-control slot (N1), and
    pinned read buffers could fragment the new per-URB pool so no write fit
    (N4). A serial device on an MCU device box (cdc-acm parks 17 reads)
    would deadlock. Now IN URBs hold at most max_urbs-2 slots, the pool keeps
    a write reserve only OUT may use, and OUT/control buffers are cut
    first-fit from the low end while IN takes best-fit from the high end.
    Invariant (yusb_export.h): an OUT never waits on reads. fuzz_export gains
    a progress oracle: every submit and unlink gets exactly one a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
2026-11-05 Never stop parsing on a read in the export core
    A confirmation review found the held set was still capped at max_urbs:
    a client with more reads outstanding than the IN slots plus max_urbs held
    entries stopped the stream at a read header, so writes and CMD_UNLINK
    behind it were never parsed (a Linux-sized proxy or cdc-acm against an
    MCU exporter). The held set now has its own size (cfg.max_held, default
    max(4 x max_urbs, 64), about 28 B each); when it is full a further IN or
    zero-length-OUT submit is answered at once with RET_SUBMIT(-ENOMEM), as a
    resource-limited stub would, and parsing continues. The stream waits only
    for an OUT data payload whose write reserve an unaccepted write holds, or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
2026-11-05 Document completion order past the export held set
    A final review confirmed write progress and answer ordering, and noted
    that an -ENOMEM answered past max_held can complete before an earlier
    pending URB on the same endpoint. State that per-endpoint completion
    order holds only within max_held and that the Yoke proxy shows the
    failure to the host as a STALL.
    [yusb_export.h]
2026-11-05 Fix the host-shell harness build and show compiler errors in CI
    CI on Ubuntu 24.04 failed to build tests/firmware_usb's host-shell
    program, but the failure was invisible: usb_build.py ran the compiler
    with check=True and captured stderr, so pytest showed only the command
    line. Clang reports the one defect in it: a 'routes' counter that was
    set but never read (-Werror). Remove it, and raise with the compiler's
    own diagnostics when a harness fails to build.
    [host_shell.c, usb_build.py]
2026-11-05 Check eventfd results in the USB box network task
    Ubuntu's gcc enables _FORTIFY_SOURCE, which marks read() and write()
    warn_unused_result, so the CI build of the host-shell harness failed on
    box_net.c's eventfd wake write and drain read. Handle both results:
    ignore EAGAIN (a full counter or an empty drain is harmless) and log any
    other error, which would lose a wake. Build the firmware_usb harnesses
    with -D_FORTIFY_SOURCE=3 so this is caught on every host, not only CI.
    [box_net.c, usb_build.py]
